michelep/ESP32_WebRadio/images/esp32_webradio.jpg

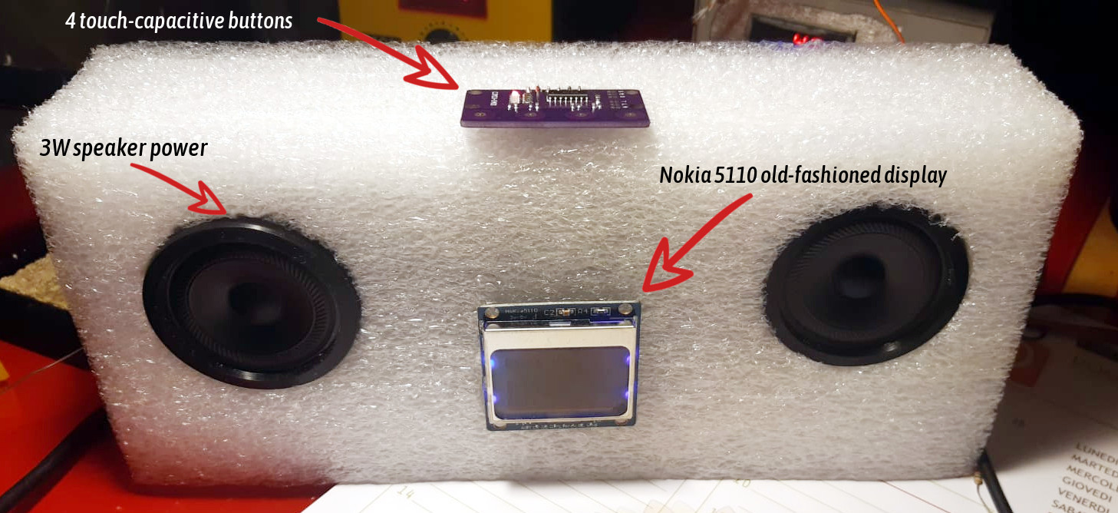
images/esp32_webradio.jpg
