michelep/ESP32_WebRadio/images/esp32_webradio_lateral.jpg

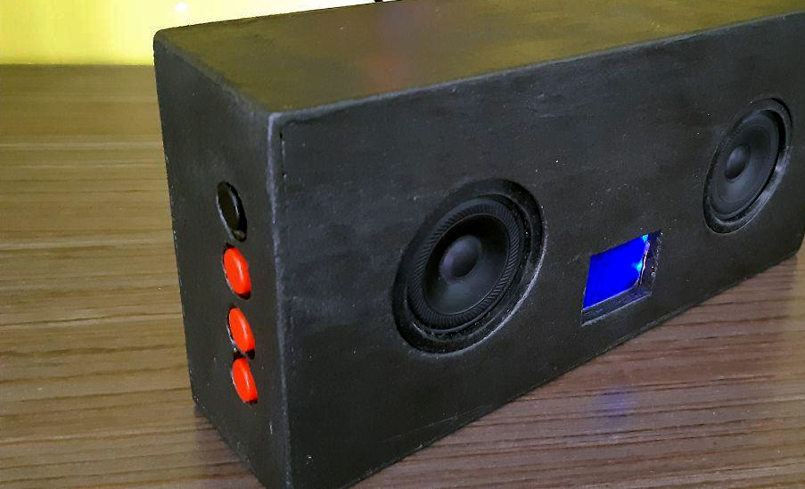
images/esp32_webradio_lateral.jpg
