michelep/ESP32_WebRadio/(threads)

Thread 1 (2021-07-27):

Question, suggestions.

smutax, 2021-07-27:
Hi Michele. First of all, let me congratulate you on such a great project! For me, it ticks all the boxes! I had to skip few similar projects in favour of yours when deciding to undertake the build. I'm planing on using max98357a which needs to be connected to corresponding pins. I've got a question, there's a mention of 4 buttons in the description and i can see 4 buttons on the picture but i only could find 3 buttons on the schematic and BOM button count is 3 too, can you clarify please? Also Michele, would you consider adding support for rotary encoder(s)( like ky-040 with  built-in button)? It could replace all 4 or 3 buttons or be an addition. My scenario would be: in default mode, encoder controls volume, encoder button (long) click enters "stream scroll mode" where you scroll through names of your preset streams, once the name of the stream is on the screen the click would initiate the switch of current stream to a new one, after that encoder returns to default volume mode. Once again, thanks for your hard work.

synchrophasotron, 2022-03-18:
Hi Michele. Please, tell me - does it support https streams?

Valentin211, 2022-03-20:
> Hi Michele. Please, tell me - does it support https streams?

Hi! It's ok, e.g: https://live.rockfm.ro/rockfm.aacp
